alexVzN/dds-sine-synthesizer/docs/04b_ip_customize.png

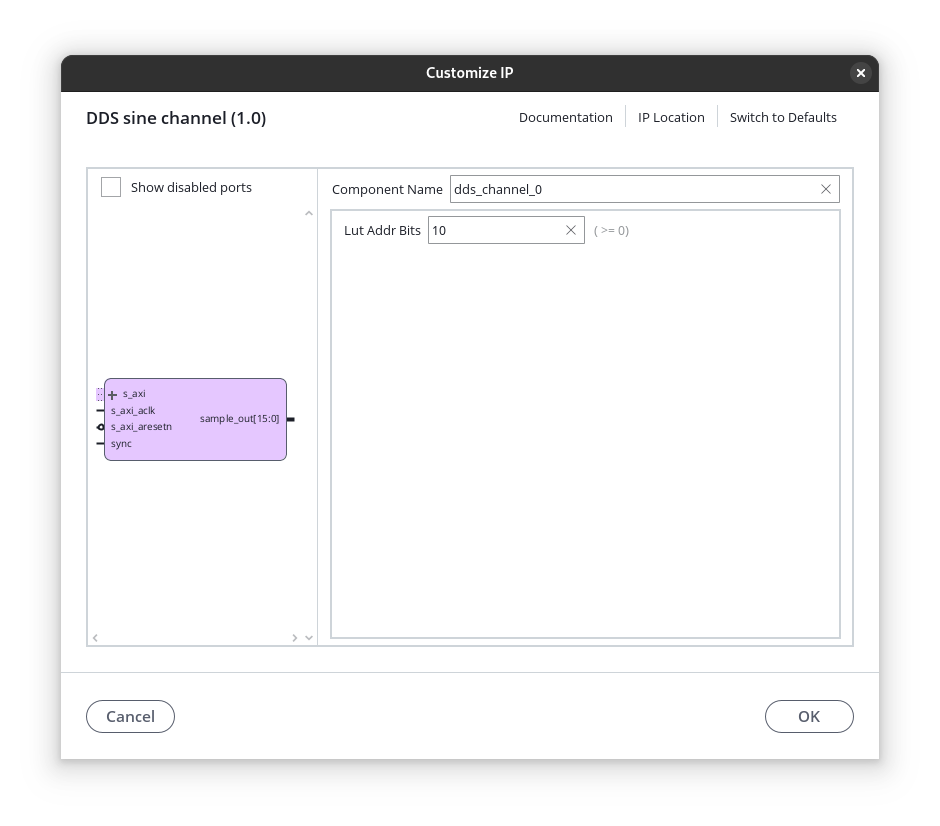
docs/04b_ip_customize.png
