alexVzN/dds-sine-synthesizer/docs/05_block_design.pdf

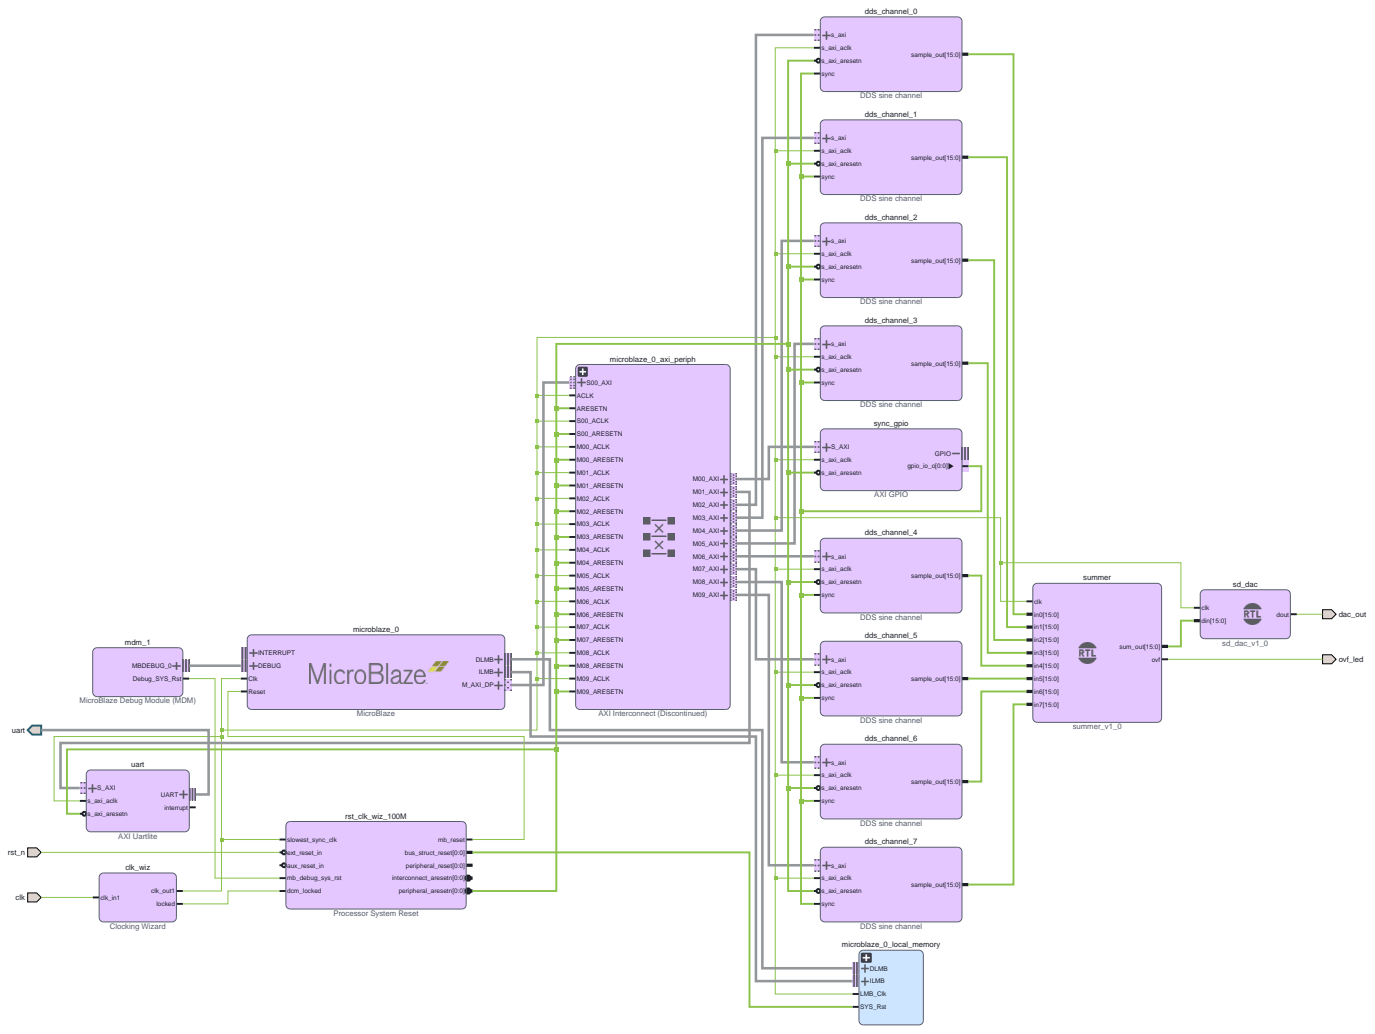
[picture p36: page 1]
clk_wiz; Clocking Wizard; clk_in1; clk_out1; locked; dds_channel_0; s_axi; s_axi_aclk; s_axi_aresetn; sync; sample_out[15:0]; dds_channel_1; dds_channel_2; dds_channel_3; dds_channel_4; dds_channel_5; dds_channel_6; dds_channel_7; mdm_1; MBDEBUG_0 Debug_SYS_Rst; microblaze_0; MicroBlaze; INTERRUPT; DLMB; ILMB M_AXI_DP; DEBUG; Clk Reset; microblaze_0_axi_periph; S00_AXI; M00_AXI M01_AXI M02_AXI M03_AXI M04_AXI M05_AXI M06_AXI M07_AXI M08_AXI M09_AXI; ACLK; ARESETN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

DDS sine channel

MicroBlaze Debug Module (MDM)

AXI Interconnect (Discontinued)

Processor System Reset
